space101org/space101org.github.io/README.md

---

## Проект space101

**Наша миссия** - сделать космические технологии доступными для всех.

**Идея** состоит в том, чтобы предложить доступный набор электроники, с помощью которого можно проводить настоящие космические эксперименты.

## Ценности проекта:
- **Универсальность:** возможность проведения различных космических экспериментов: от приема сигналов со спутников до разработки и испытания собственного космического аппарата.
- **Низкая стоимость:** возможность покупки базового набора всеми желающими.
- **Доступность:** применение простых способов соединения частей, сборки и настройки, не требующих специальных знаний.
- **Открытость:** все инструкции доступны на сайте, все детали можно найти и купить самостоятельно.

## Вы сможете создать
- **собственную наземную станцию** и принять данные со спутников
- **космический аппарат формата cubesat** и запустить его в "ближний космос"
- **радио-мессенджер** и общаться с друзьями без использования интернета

Все необходимые компоненты вы можете купить у нас или заказать самостоятельно.

## Содержание:  
* Сборка набора  
* Сборка антенны  
* Приемная станция  
   * О приемной станции  
   * Прошивка станции  
   * Настройка станции  
   * Декодирование данных  
* Космический аппарат  
   * О кубсате  
   * Корпус кубсата  
   * Прошивка кубсата  
   * Запуск кубсата
