space101org/space101org.github.io/docs/station/station-firmware.md

---
title: Прошивка станции
---

Для того, чтобы наша приемная станция заработала, нужно записать на нее программу (прошивку). Для этого подсоедините устройство к компьютеру (ноутбуку) с помощью кабеля TypeC–USB. Также убедитесь, что доступно подключение к wifi.  

## Установка драйверов

Первым делом необходимо установить драйвера, чтобы компьютер "увидел" наше усройство.
Скачайте архив с драйвером по данной ссылке: [CP210x_Universal_Windows_Driver.zip](../CP210x_Universal_Windows_Driver.zip). Нажмите на него правой кнопкой мыши и выберите пункт `Извлечь все`.

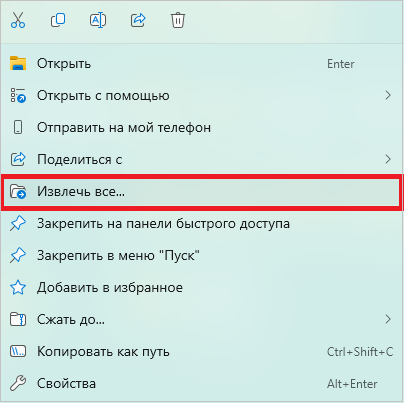
[picture p27: docs/station/images/station-firmware-driver-rightclick.png]


В открывшемся окне выберите папку, в которую будут распакованы файлы, и нажмите кнопку `Извлечь`. 

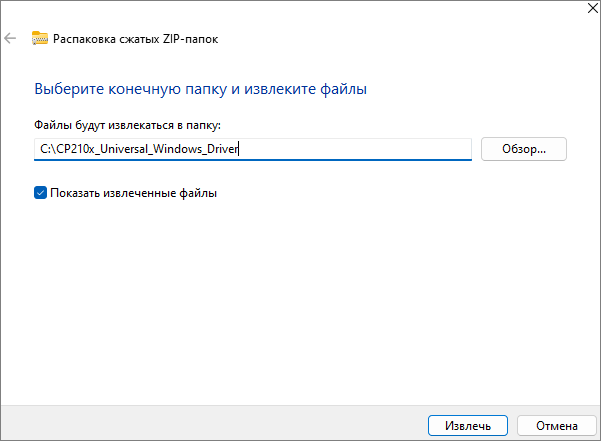
[picture p28: docs/station/images/station-firmware-driver-extract.png]


После распаковки откроется папка с файлами драйвера. Найдите в ней установочный файл **silabser.inf**. 

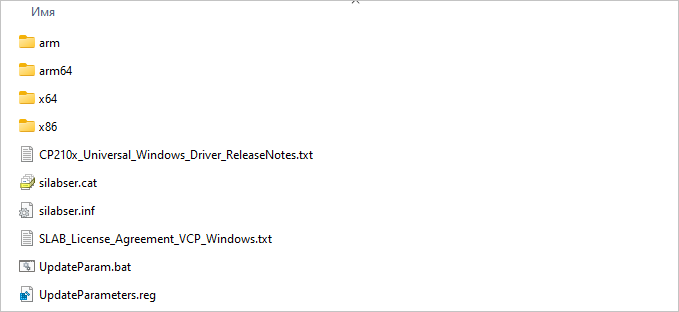
[picture p29: docs/station/images/station-firmware-driver-files.png]


Нажмите на установочный файл правой кнопкой мыши и выберите `Установить`. Дождитесь сообщения об успешной установке драйвера.

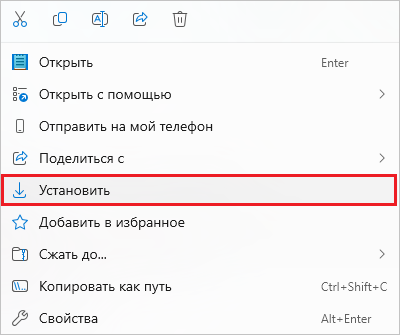
[picture p30: docs/station/images/station-firmware-driver-install.png]


Дождитесь сообщения об успешной установке драйвера.

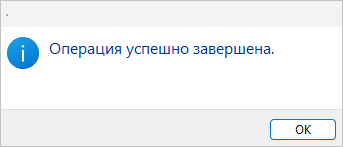
[picture p31: docs/station/images/station-firmware-driver-complete.png]


## Установщик TinyGS

Для прошивки нашей приемной станции мы будем использовать популярный сервис **TinyGS**, с помощью которого люди по всему земному шару имеют возможность принимать данные с космических аппаратов.
Зайдите на сайт [https://installer.tinygs.com/](https://installer.tinygs.com/). Подключите устройство кабелем к компьютеру и нажмите кнопку `Install`.

<details>
  <summary>Если сайт не загружается</summary>

  Сайт tinygs.com не заблокирован в России, однако часто возникают проблемы с его загрузкой.

  Нажмите комбинацию клавиш `Win` + `I`, откроется окно "Параметры". Затем в столбце слева нажмите "Сеть и Интернет" и выберите "Прокси-сервер". Затем нажмите "Использовать прокси-сервер", в открывшемся окне включите ползунок и введитете IP-адрес и порт:  

  `45.93.214.106`  
  `8000`

  В поле "Не использовать прокси-сервер для адресов которые начинаются с указанных ниже записей" введитете

  `192.168.*.*`  

  Поставьте галочку "Не использовать прокси-сервер для локальных (внутрисетвеых) адресов".  
  Нажмите кнопку `Сохранить`.

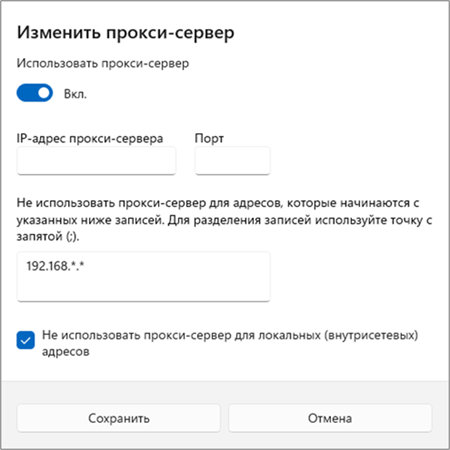
[picture p32: docs/station/images/station-firmware-proxy.png]
  

  Теперь в попытке входа на сайт система спросит логин и пароль. Введите следующие:

  Логин: `V6G6AV`  
  Пароль: `vbcoHq`

  Когда завершите работу с сайтом **tinygs.com**, не забудьте в окне "Редактировать настройки прокси" сдвинуть ползунок в положение `Выкл.` и нажать кнопку `Сохранить`.
</details>

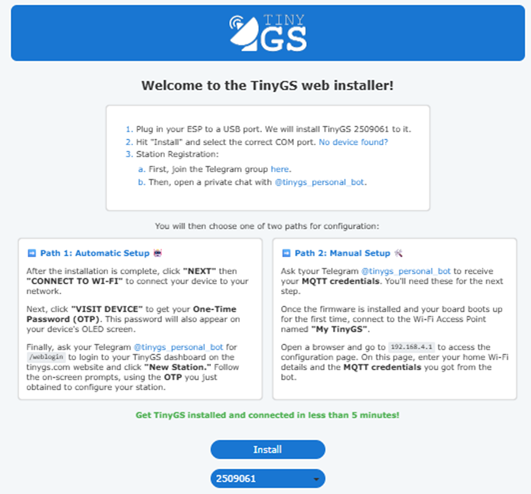
[picture p33: docs/station/images/station-firmware-welcome.png]


## Подключение к станции

Откроется окно, в котором необходимо разрешить установщику обратиться к нашей станции. В списке устройств выберите наименование устройства, как показано на изображении, и нажмите кнопку `CONNECT`. COM-порт, указанный в скобках, может отличаться.

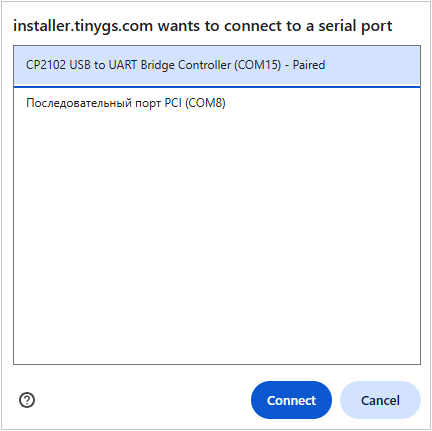
[picture p34: docs/station/images/station-firmware-connect.png]


## Начало установки

Для начала установки в появившемся окне нажмите `INSTALL TINYGS`.

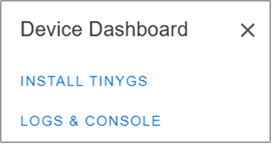
[picture p35: docs/station/images/station-firmware-install.png]


## Удаление старой прошивки

Установщик предложит стереть память устройства перед записью прошивки. Поставьте галочку `Erase device`. Так в станции не останется старых настроек и данных. Для продолжения нажмите `NEXT`.

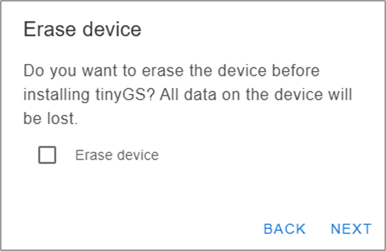
[picture p36: docs/station/images/station-firmware-erase.png]


## Подтверждение установки

В появившемся окне подтвердите установку нажав на кнопку `INSTALL`.

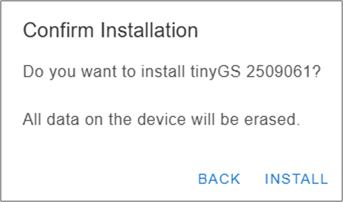
[picture p37: docs/station/images/station-firmware-confirm.png]


## Процесс установки

Начнется запись прошивки. На экране появится индикатор прогресса. Процесс занимает несколько минут: не закрывайте страницу и не отключайте кабель, пока установка не завершится.

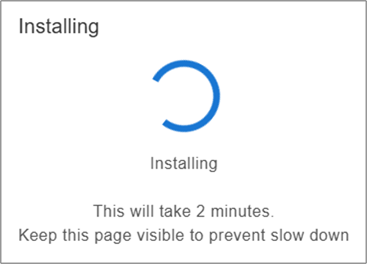
[picture p38: docs/station/images/station-firmware-installing.png]
  

## Завершение установки

Когда прошивка будет записана, в окне появится надпись **Installation complete!** Это значит, что станция успешно прошита. Нажмите кнопку `Next`.

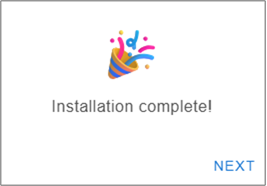
[picture p39: docs/station/images/station-firmware-complete.png]
  

## Подключение к WiFi

Станции нужен доступ к интернету, чтобы передавать на сервер TinyGS принятые спутниковые данные. Выберите в списке вашу WiFi-сеть, введите пароль и нажмите `Connect`.

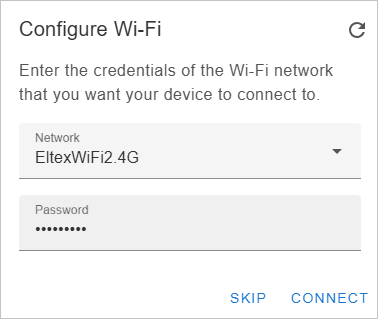
[picture p40: docs/station/images/station-firmware-wifi.png]
  

## Станция прошита

Если подключение выполнено успешно, в окне появится кнопка `VISIT DEVICE`. Станция прошита и подключена к сети - теперь ее необходимо настроить. Именно с этого окна мы начнем следующий шаг.

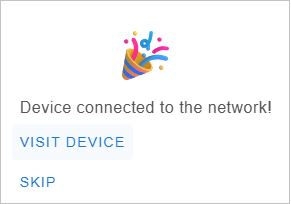
[picture p41: docs/station/images/station-firmware-visitdevice.png]
