space101org/space101org.github.io/docs/cubesat/images/cubesat-electronics-blockconnected.png

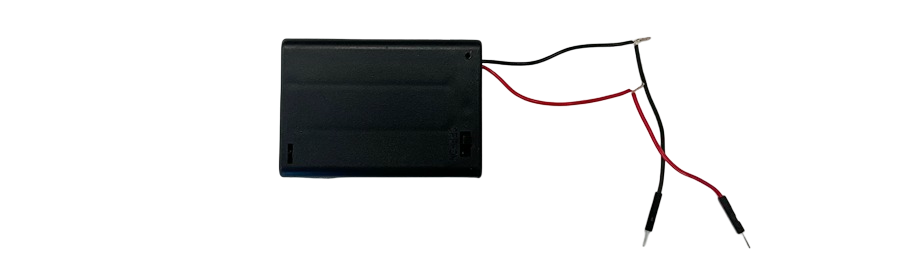
docs/cubesat/images/cubesat-electronics-blockconnected.png
