space101org/space101org.github.io/static/img/radio_messenger.png

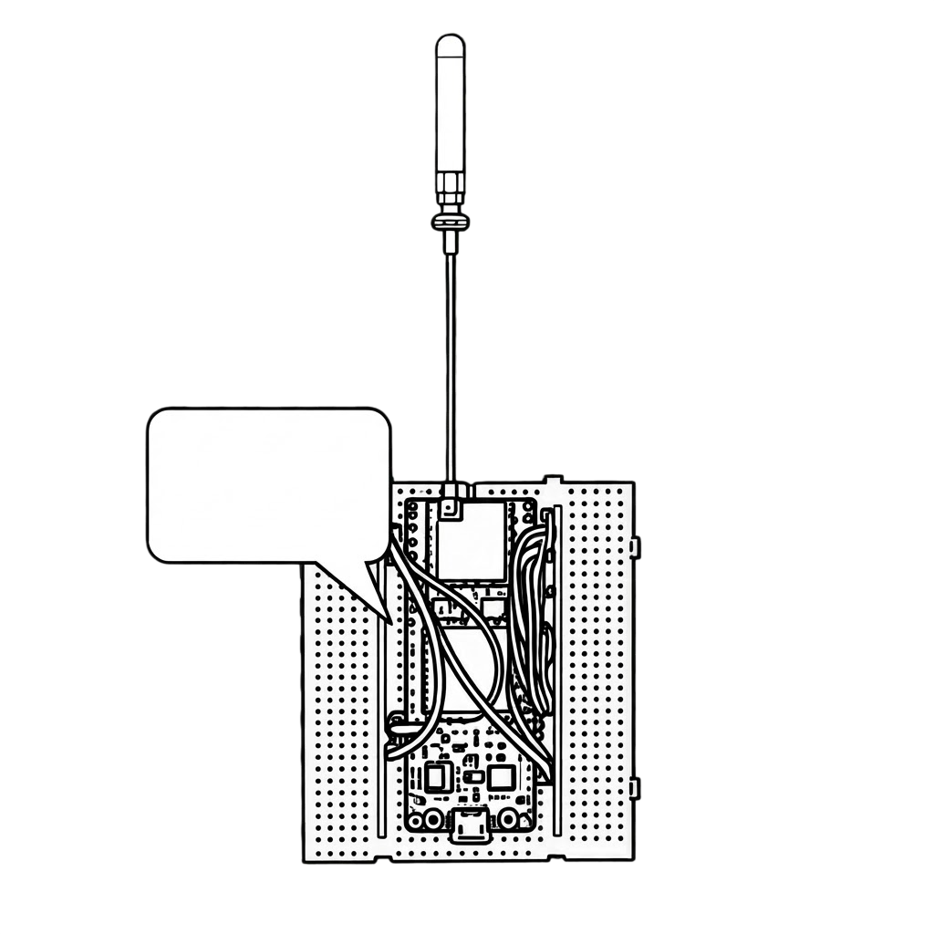
static/img/radio_messenger.png
