space101org/space101org.github.io/docs/cubesat/images/cubesat_light.step

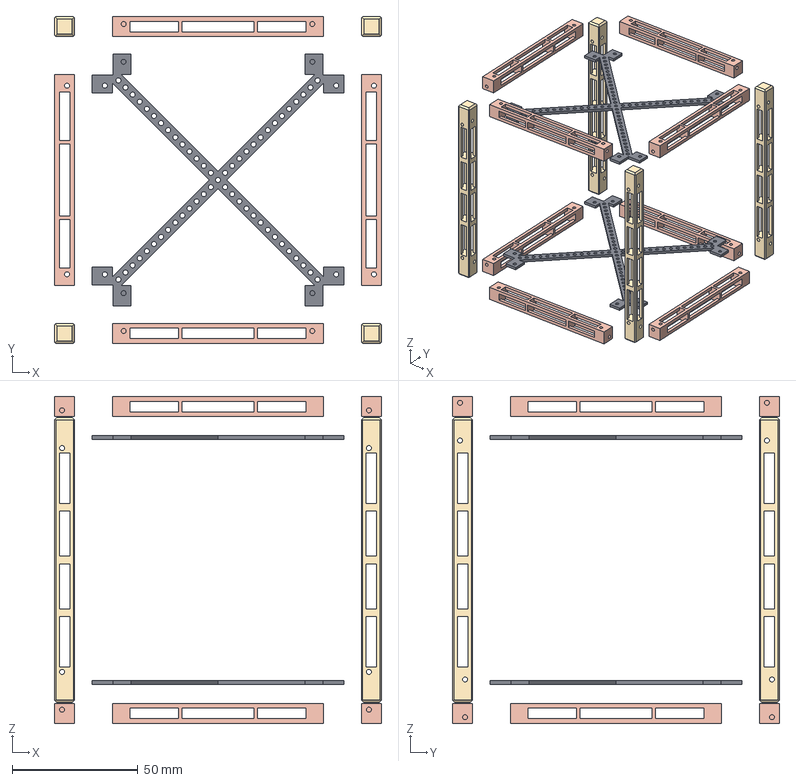
[picture p45: CAD file, 2026-11-12]
docs/cubesat/images/cubesat_light.step
130.0 x 130.0 x 130.0 mm
vertical_rail_1 x 4
crossbeam_1 x 8
panel_bottom
panel_top
