space101org/space101org.github.io/(list of files, cad)

Other CAD files:
docs/cubesat/images/cubesat_standart.stl
