space101org/space101org.github.io/docs/station/images/station-assembly-breadboard_all_wires.png

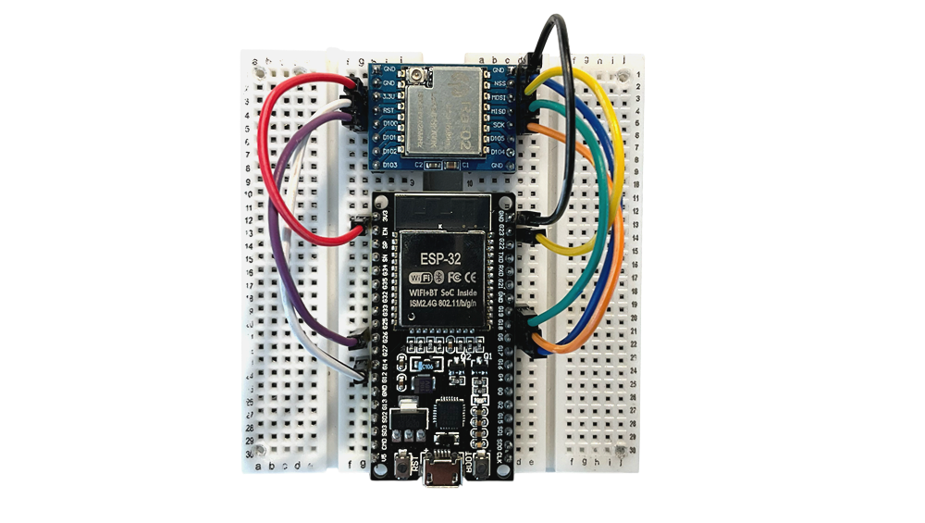
docs/station/images/station-assembly-breadboard_all_wires.png
