space101org/space101org.github.io/docs/station/images/station-assembly-breadboard_esp32.png

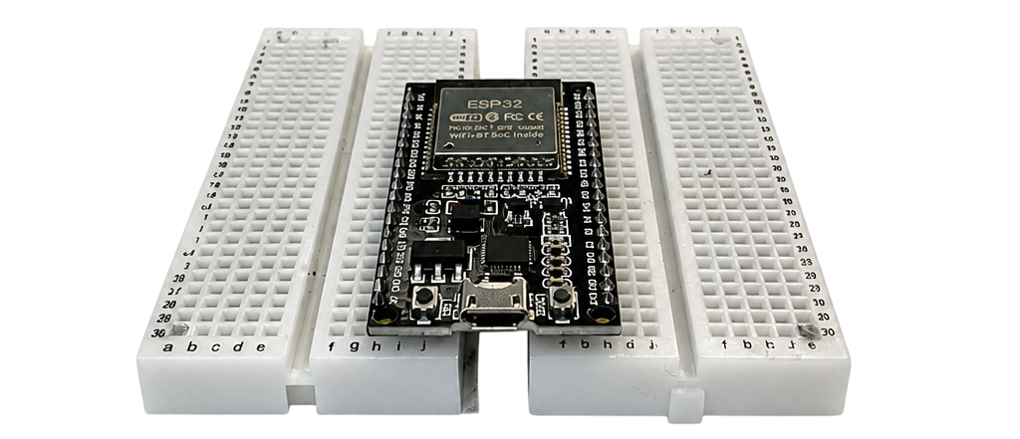
docs/station/images/station-assembly-breadboard_esp32.png
