space101org/space101org.github.io/docs/station/images/station-assembly-breadboard_esp32_ra02.png

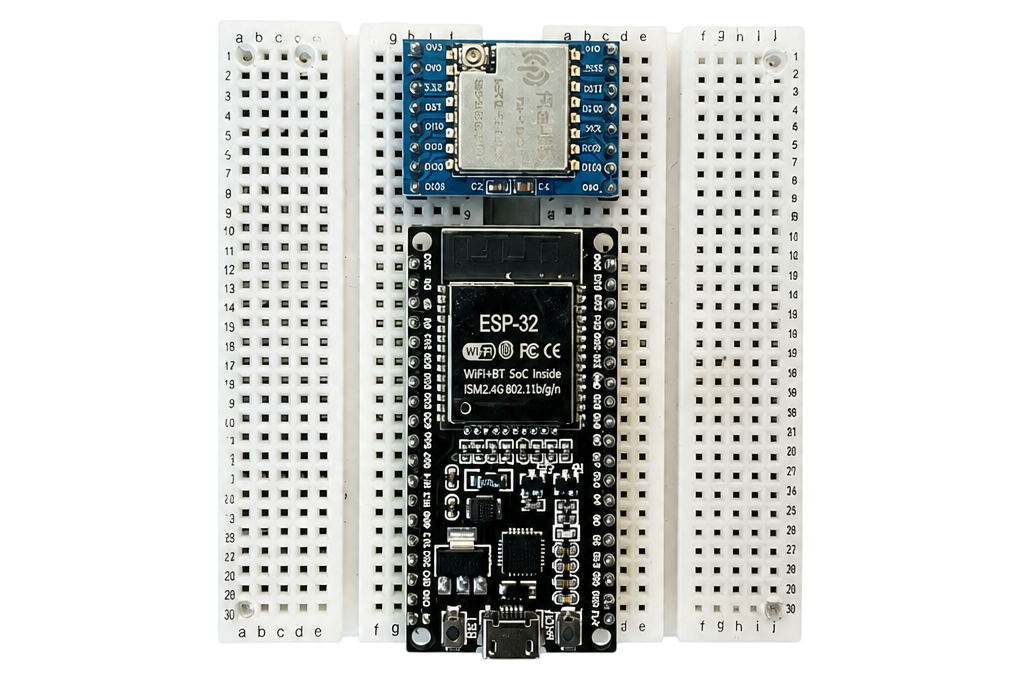
docs/station/images/station-assembly-breadboard_esp32_ra02.png
