space101org/space101org.github.io/docs/station/images/station-assembly-breadboard_ready.png

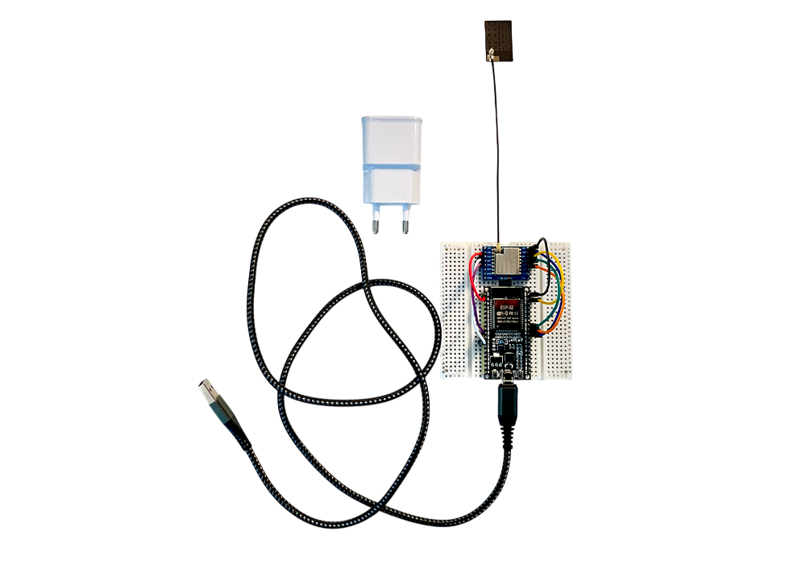
docs/station/images/station-assembly-breadboard_ready.png
