space101org/space101org.github.io/docs/station/images/station-assembly-breadboards.png

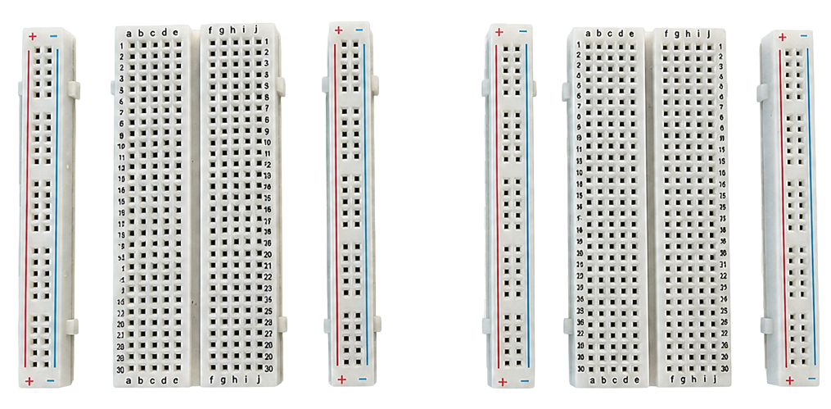
docs/station/images/station-assembly-breadboards.png
