space101org/space101org.github.io/docs/station/images/station-assembly-components.png

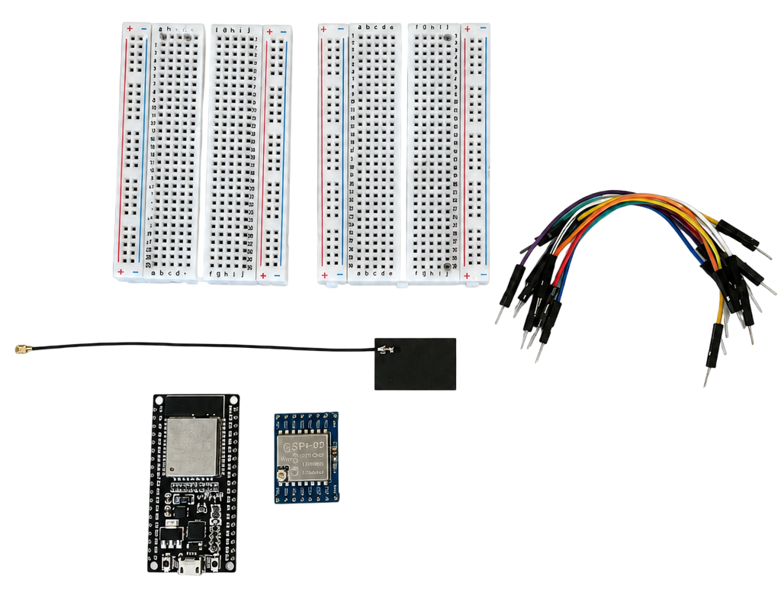
docs/station/images/station-assembly-components.png
